Maxsunset/SilverGuard/SilverGuard/docs/老人摔倒检测系统-三序工坊队-2026.11.pptx

基于视觉，32单片机和物联网的老人摔倒检测系统

硬件/视觉：卢冠桦　STM32:陈哲 物联网：黄海巍
队伍：三序工坊队　　答辩日期：2026 年 11月

Notes: 开场：各位评委老师好，我们的项目是基于视觉和物联网的老人摔倒检测系统。用一台普通笔记本加一个普通摄像头，实时判断画面里的老人有没有摔倒，摔倒后不到半秒就报警，并通过 USB 转串口把信号送给单片机。整套系统不用显卡、不用穿戴设备，全部代码约 1000 行，中文注释完整。

## Slide 2

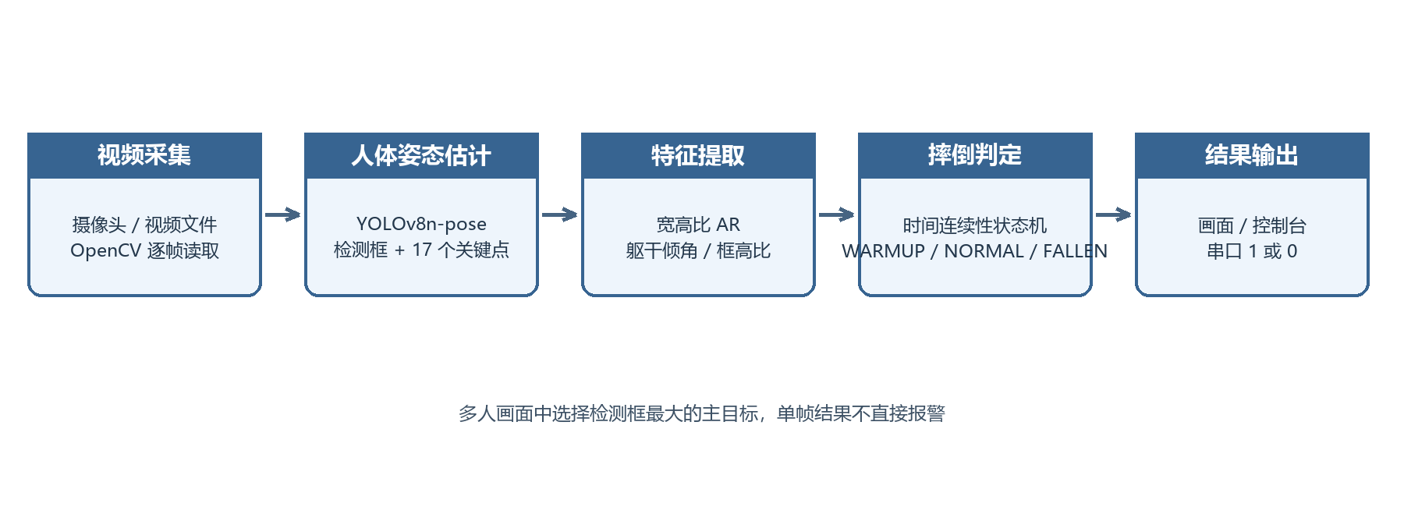
[picture p18: figure]

## Slide 3

三种姿态，用宽高比把蹲下和平躺分开

姿态 | 躯干倾角 | 宽高比 | 框高比
站立 | 0 ~ 9° | 0.30 ~ 0.80 | 0.93 ~ 1.04
蹲下 | 10 ~ 50° | 0.70 ~ 1.40 | 0.35 ~ 0.50
平躺 | 80 ~ 90° | 2.90 ~ 3.30 | 0.30 ~ 0.33

关键发现：蹲下和平躺的框高几乎一样（都缩到站立身高的 0.3~0.5），“框变矮”分不开两者
真正分得开的是宽高比：蹲下最多 1.4，平躺至少 2.9，中间有很宽的空白地带
把“框确实变宽”设为硬门槛后：蹲下一定不报，平躺一定报

倒地判定
宽高比 ≥ 1.8
且（躯干倾角 ≥ 60° 或 框高比 ≤ 0.55）

Notes: 这一段是演示场景的核心。实测数值来自真实视频逐帧测量，见 outputs/产品报告 第 3.5 节。

## Slide 4

# 宽高比门槛：蹲下不超过 1.4，平躺通常大于 2.9，因此取中间值 1.8

AR_THRESHOLD = 1.8
# 躯干与竖直方向的夹角：0° 为站直，90° 为完全躺平

ANGLE_THRESHOLD = 60.0
# 当前框高低于站立身高的 55%，作为倒地的辅助证据

COLLAPSE_RATIO = 0.55
def extract_features(kps, conf, box):
"""从检测框和关键点计算摔倒判定特征。"""
x1, y1, x2, y2 = [float(v) for v in box]
box_w = max(x2 - x1, 1e-6)
box_h = max(y2 - y1, 1e-6)

# 左右肩、左右髋分别取中点；单侧不可见时用另一侧代替

shoulder = _mid(_point(kps, conf, L_SHOULDER),
_point(kps, conf, R_SHOULDER))
hip = _mid(_point(kps, conf, L_HIP),
_point(kps, conf, R_HIP))
angle = None
if shoulder is not None and hip is not None:
dx = hip[0] - shoulder[0] # 肩髋之间的水平偏移
dy = hip[1] - shoulder[1] # 肩髋之间的垂直偏移
# 相对竖直方向的夹角，画面 y 轴向下不影响绝对值计算

angle = math.degrees(math.atan2(abs(dx), abs(dy) + 1e-6))
return {"aspect": box_w / box_h,
"angle": angle,
"box_height": box_h}

## Slide 5

一个字符（摔倒 1 / 正常 0）

信号 | 发送时机 | 单片机动作
字符 1 | 确认摔倒（每 100 毫秒重发） | 蜂鸣器 + 红灯 + 继电器
字符 0 | 正常 / 已恢复（每 100 毫秒重发） | 全部输出复位

默认只发一个字符：单片机一个 if 就能用
正常时每 100 毫秒发一次 0、摔倒后一直发 1、人起身又变回 0（★ 摔倒期间重发的仍是 1)

Notes: 单片机那一半的工作量可以压到不到 20 行。完整接线、协议表、故障排查见 outputs/单片机对接指南.md。PC 侧默认 115200、8N1，发的是单个字符不带换行。现场如果单片机没反应，先跑 mcu_link.py --diag 看实际生效的波特率和写出的字节数：有字节数就说明 PC 没问题，再查波特率是否一致、TX/RX 是否接反、GND 是否共地、单片机代码是不是在等换行。

## Slide 6

def __init__(self, link, detector, interval=0.1):
self.link = link
self.detector = detector
self.interval = interval
self._stop_event = threading.Event()
self._thread = threading.Thread(target=self._run, daemon=True)
def _run(self):
next_at = time.monotonic()
while not self._stop_event.is_set():
# 只发送单字节 ASCII：摔倒 = '1'，正常/恢复 = '0'

data = b"1" if self.detector.state == "FALLEN" else b"0"
self.link.write(data) # write 内部会 FlushFileBuffers
next_at += self.interval
delay = next_at - time.monotonic()
if delay < 0: # 发送偶发超时后重新对齐节拍
next_at = time.monotonic() + self.interval
delay = self.interval
self._stop_event.wait(delay)
def start(self):
self._thread.start()
def stop(self):
self._stop_event.set()
self._thread.join(timeout=1.0)

## 硬件优点

采用12V电池独立供电，利用DCDC+LDO输出5V和3.3V，可在停电下运行

01

模块化设计，便于更换

02

## 单片机

## Slide 9

02 / 开源

全部源码与文档开源：可复现、可追溯

github.com/Maxsunset/SilverGuard

完整源码 · 接线文档 · 关键修复的提交记录

源码

固件全部源码（Core/Src · SSD1306 驱动 · CMSIS）

文档

docs/wiring.md：引脚与接线，含 ESP8266 八脚说明

可追溯

关键修复都有提交记录，能查到“为什么这么改”

⭐ 我们不只给出“能跑的代码”，也给出“为什么这样写”的依据。

02

## Slide 10

05 / 架构

四层架构：感知 → 决策 → 执行 → 远程

感知层

摄像头 + 视觉判断（上位机）→ 串口每 100 ms 1 字节（0=正常 / 1=摔倒） · 按键（PA0）

决策层

六态状态机 · 定时器节拍 · 看门狗

执行层

OLED 汉字屏 · 蜂鸣器警笛 · 报警灯 · 语音播报

远程层

ESP8266（USART1）→ MQTT → 手机 / 小程序

⭐ 关键取舍：判断在本地完成、结果立刻联网；画面与视频上云作为可选扩展

05

## Slide 11

07 / 核心设计 ②

本地三层滤波：让报警只在真的需要时响

5 帧连续窗口
抗抖动

串口每 100 ms 一帧，连续 5 帧完全一致才更新结论

①

→ 单帧抖动、误码被直接丢弃

②

5 s 检查窗
可撤销

进入检查后仍采信上位机：报 0 立即退回待机，满 5 s 才升级

→ 短时误报在 5 s 内自动撤销

③

10 s 本地确认
拒收信息

进入预备报警后不再采信串口结论，只能长按取消或等 10 s 到期

→ 确认期内不会被后续数据“翻盘”

⭐ 三层是串联的：任何一层没通过，都不会进入正式报警

07

## Slide 12

06 / 核心设计 ①

全自动监控：摄像头在家里看懂，只把结论发出去

摄像头采集

现场摄像头持续拍摄

本地视觉判断

PC 端运行 Python 视觉

只发结果

串口每 100 ms 1 字节：0 正常 / 1 摔倒

多级确认

STM32 状态机逐级升级报警

▍识别在本地 视觉判断在本地完成，串口只传 0/1，通信量极小
▍心跳即在线 每 100 ms 一帧；200 ms 收不到就判掉线，屏幕与手机同时反映
▍两条腿走路 联网是核心价值；本地声光与语音不依赖网络

⭐ 一句话：监控是自动的，判断在本地，结论第一时间联网到家人手机。

06

## Slide 13

08 / 核心设计 ③

心跳检测：100 ms 一帧，200 ms 判掉线

为什么 100 ms 一帧

视觉 10 fps 足够判断跌倒；字节级上报，流量极小（每帧仅 1 字节）

上位机每 100 ms 发 1 字节

为什么 200 ms 判掉线

≈ 容忍 1 次丢帧，又不至于“断了很久还显示在线”；心跳周期 : 掉线阈值 = 1 : 2

掉线后怎么恢复

屏幕显示离线；上位机继续发心跳，收到即回到待机/检查（无需重启）

连续 2 帧未到 = 200 ms → 判掉线

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
⭐ 一串 0/1 里没有“我还活着”的信息，所以心跳必须单独设计——这就是这层的全部理由。

08

## Slide 14

09 / 核心设计 ④

六态状态机：不止单向推进，按键可随时跳变

① 主路径：数据与定时驱动

offline

断线/无信号

3 s

0

standby

在线待机

1（直通）

1

0（退回）

checking

确认中 5 s

5 s

standby

② 跳变：按键长按 / 心跳掉线

3 s

3 s

掉线

长按

offline

长按

alarm

长按

alarm_cancel

取消确认 3 s

alarm

报警中

10 s

pre_alarm

预备报警 10 s

checking

掉线

数据 / 定时

长按（按钮）

掉线（200 ms 无心跳）：仅 standby / checking 会回 offline

09

## Slide 15

10 / 核心设计 ⑤

看得见、听得到：没有手机也要能自救

手段 | 实现方式 | 设计要点
屏幕提示 | 128×64 OLED（I²C1），自绘 16×16 汉字点阵 | 汉字直读，不用记图标含义
警笛声 | TIM3 PWM 驱动蜂鸣器：1.80–3.00 kHz 扫频、占空比 ≈50% | 扫频更“抓耳”，不会和家电提示音混淆
报警灯 | PB0 独立灯，报警时点击闪烁（12 V 高电平点亮） | 听不见也能看见
语音播报 | SYN6288（USART3，9600）：报警/取消语音提示 | 安抚 + 指导，降低恐慌

⭐ 一个细节：蜂鸣器模块是“低电平触发”，因此“关闭”必须输出恒高，否则待机会一直通电发热。
我们最终把“关闭态”定义为 CCR > ARR（PWM 恒高），待机电流才回到 ≈0。

10

## Slide 16

12 / 核心设计 ⑦

掉电、死机、抖动：让“报警”不会因为意外而丢

看门狗（IWDG）

主循环每轮喂狗，约 6.5 s 未喂即复位；任何一路卡死都能自恢复

报警状态存 BKP

报警中意外复位，重新上电后仍回到“报警中”，不会悄悄安静下来

只发“变化”

状态未变不重复上报；网络恢复后补发当前状态，避免手机端停在旧状态

去重与短路保护

状态去重 + 发送失败退避，避免刷屏与“假在线”

12

## Slide 17

物联网

## Slide 18

整体链路 ｜ 一条摔倒消息的完整旅程

先看全景图，后面每一页拆开讲其中一段

⭐ 单片机只负责"发现"，小程序负责"把摔倒变成一次可靠的、能送到人手上的报警"。

02

02 / 10

📟

单片机

加速度传感器
检测到摔倒

EMQX 服务器

公共 MQTT Broker
消息中转站

📡

连上 Broker 收消息
解析 · 去重 · 存库

📱

微信云开发

云函数 + 云数据库
兜底落库 · 发通知

☁️

👵

家人手机

订阅消息弹窗
几秒内知道

➜

➜

小程序

➜

➜

① 连接：小程序 ↔ 单片机怎么见面

小程序不能直连单片机的 WiFi 热点，双方通过 MQTT 协议在一个公共服务器（Broker）上"见面"——单片机往主题里发消息，小程序订阅同一个主题就能收到。对应第 3–5 页。

② 运作：收到消息后小程序做什么

解析消息格式 → 15 秒去重 → 写入本地与云端 → 弹窗告警 → 云函数发订阅消息给家人。断网还能自动重连、补齐漏掉的记录。对应第 6–8 页。

③ 界面：三个页面怎么呈现这些数据（第 9 页）

④ 总结：一条消息从头到尾 8 步走完（第 10 页）

## Slide 19

连接 ① ｜ 小程序怎么"看见"单片机的消息

双方都连同一个公共 MQTT 服务器，靠"主题"对上话

utils/mqtt-client.js —— 建立连接（真实代码）

wx.connectSocket({
url: 'wss://broker.emqx.io:8084/mqtt', // wss = 加密 WebSocket；8084 是 MQTT over WS 的端口
protocols: ['mqtt'], // ★ 必须声明子协议 mqtt，少这一行握手直接失败
})
this._socket.onOpen(() => this._sendConnect()) // Socket 打开后，立刻发 CONNECT 登录报文（下一页）

⭐ 单片机和手机不直接认识对方——它们只是在同一个"留言板"上，一个写、一个读。

03

03 / 10

MQTT 是什么？——一条"留言板"

单片机把消息发到主题 silverguard/fall 上， 小程序订阅同一个主题——谁发的、谁收的，中间服务器全管。

小程序的特殊限制

微信不允许小程序开普通 TCP 连接（MQTT 默认的 1883 端口用不了）， 只能走 wx.connectSocket 的 WebSocket——所以握手方式要变通。

硬性要求 ①：protocols: ['mqtt'] 不传，服务器返回的不是 101 状态码，连接必挂——这是实测踩过的坑。

硬性要求 ②：地址必须以 wss:// 开头——微信强制加密连接，ws:// 明文会被拒。

## Slide 20

连接 ② ｜ CONNECT 登录报文：亲手拼二进制

小程序没有现成 MQTT 库可用——CONNECT 报文是一个字节一个字节拼出来的

⭐ 握手成功只差一个字节——标志位必须与报文里实际带的字段完全一致。

04

04 / 10

utils/mqtt-client.js —— CONNECT 报文核心（节选）

// 可变头：协议名 "MQTT" · 协议等级 Level 4 · keepAlive 60 秒
const flags = 0x02 // 只有 cleanSession 一个标志位
// 0x02 = 0000 0010：第 1 位表示"清会话"
// ★ 不能顺手写 0xC2（1100 0010）——那是"带用户名+密码"
// 的标志，但报文里并没有这两个字段，标志位与实际
// 内容不一致，Broker 会按协议错误直接断开连接
buf.push('MQTT'.length, ...bytes('MQTT'), 4, flags, 0, 60)

为什么手写？

npm 上的 MQTT 库依赖 TCP 和 Node API，小程序环境跑不起来——只能按协议文档自己拼字节。

flags：身份的"暗号"

8 个比特每个都有含义。填了"有密码"却没给密码，等于对暗号对不上，当场被踢。

clientId：手机用 silverguard-app-xxx，设备用 silverguard-dev-1——同一主题下互不干扰。

keepAlive 60s：每 60 秒互发一次心跳，服务器据此判断单片机还在线没在线。

## Slide 21

运作 ① ｜ 单片机"说的话"：一条消息长什么样

摔倒时单片机只发一串文字，小程序负责把它翻译成报警

utils/fall-handler.js —— 消息解析（核心节选）

function handle(payload) { // 所有设备消息的唯一入口
if (payload === 'online' || payload === 'offline') {
emitter.emit(EVENT_DEVICE, payload) // 在线报文：只刷新图标，不写记录、不告警
return
}
if (!/^1\/0\/fall/.test(payload)) return // 正则判断：不是摔倒报文就忽略
if (isDuplicate(true, Date.now())) return // 15 秒去重（下一页细讲）
saveAndAlert({ device: '1', fell: true, ts: Date.now() }) // 入库 + 弹窗告警
}

05

05 / 10

设备编号

1

/

0 = 检测到摔倒

0

/

fall

事件类型

/

normal

来源备注

设计要点：两种报文走两条分支——摔倒事件要"留痕 + 喊人"，在线状态只改一个图标。职责分清，互不掺和。

为什么用正则：/^1\/0\/fall/.test() 一行就能确认"这是设备 1 发的摔倒"，比字符串切割更稳。

⭐ 单片机只发一串字符，"翻译成报警"的全部智能都在小程序这一端。

## Slide 22

运作 ② ｜ 确认是摔倒后：去重 → 入库 → 喊人

一次摔倒只响一次铃——15 秒去重窗是秩序的关键

utils/fall-handler.js —— 15 秒去重窗（真实代码）

const DEDUPE_WINDOW = 15000 // 15 秒（毫秒）

function isDuplicate(fell, ts) {
const last = records.find(r => r.fell === fell)
// 找最近一条同类记录
return last && ts - last.ts < DEDUPE_WINDOW
// 距上次摔倒不到 15 秒 → 是同一次
}

信号可能经两条路径各到一次，不去重就会记两条——入口处统一去重，所有链路自动受益。

⭐ 四步流水线只做 200 毫秒——老人摔倒到小程序报警，比拨一个电话快得多。

06

06 / 10

解析 · 认出摔倒报文

1

去重 · 15 秒内只认一次

2

入库 · 本机 + 云数据库

3

告警 · 弹窗震动 + 通知家人

4

告警做什么：页面状态变红、本机弹窗 + 震动（实测 TOAST_OK），并把事件交给云函数去发微信订阅消息。

JS 语法点：find() 在数组里找第一条满足条件的记录——比 for 循环更短、更不易写错。

## Slide 23

运作 ③ ｜ 断网、切后台：消息凭什么不丢

两道保险：断了自动重连，漏了按时间补齐

07

07 / 10

保险 ① · 自动重连（mqtt-client.js）

onClose() {
setTimeout(() => this.connect(), 10000)
// 连接断了：10 秒后自动重连
}
onShow() {
if (!this._link) this.connect()
// 用户切回小程序时，再查一次
}

小程序切后台、锁屏都会被微信挂起断线——重连是常态，必须自动化。

保险 ② · 增量补齐（cloudbus.js）

const { data } = await db.collection('fall_events')
.where({ ts: _.gt(lastTs) })
// 只拉"上次看到的时间点之后"的
.orderBy('ts', 'asc').get()
data.forEach(e => saveAndAlert(e, { quiet: true }))
// 补齐的旧事件只入库，不弹窗吓人

断线期间发生的摔倒会先落到云数据库——重新连上后按时间戳把漏掉的补回来。

lastTs 是什么：本机记着"最后看到哪条"，断线重连后从它往后拉——不多不少，正好补上缺口。

quiet: true 的体贴：补齐只更新列表，不连弹一串旧告警——可靠但不吓人。

⭐ 网络会断、小程序会被挂起——但"重连 + 补齐"让记录一条都不少。

## Slide 24

运作 ④ ｜ 云端半场：云函数落库 + 实时推送手机

云函数负责"存下来、喊出去"，watch 负责"页面立刻变"

⭐ 云端 = 可靠的记事本 + 喊话员；watch = 页面和云端之间的一条"专线"。

08

08 / 10

云函数 mqttWebhook（节选）

exports.main = async (event) => {
await ensureCollection('fall_events')
// 集合不存在就自动建，零手工配置
await addDoc('fall_events', {
...payload, ts: uniqueTs(),
}) // uniqueTs：同毫秒事件 +1ms，
// 增量拉取时一条不漏
await sendFallAlert(payload) // 逐人发通知
}

云函数跑在腾讯服务端——小程序没开它也在工作。

小程序端 watch 实时订阅（cloudbus.js）

this._watcher = db.collection('fall_events')
.where({ ts: _.gt(lastTs) })
.watch({
onChange: (snapshot) => {
refresh(snapshot.docs)
// 云端一有新记录，页面立刻更新
},
})

watch 是云数据库的"长连接"——不用轮询刷新，数据到了推给你。

家人怎么收到：云函数调用微信订阅消息接口，锁屏也能弹出通知——通知只能服务端发，小程序自己发不了。

JS 语法点：...payload 展开运算符把旧对象的字段摊开进新对象，改哪项补哪项。

## Slide 25

界面 ｜ 三个页面，各自管一件事

老人看得清、家人查得到、你自己测得了

⭐ 三个页面各司其职：首页管"现在"，记录管"过去"，我的管"以后怎么用"。

09

09 / 10

· 一块大卡片显示设备在线状态：绿色在线 / 红色摔倒 / 灰色离线——不给"假在线"信号
· 摔倒时整页变红 + 弹窗 + 震动
· 数据由全局消息总线推送，页面只负责"显示结果"

· 历史摔倒记录按时间倒序排列
· 支持按"摔倒 / 自测"筛选
· 数据来自云数据库，断线补齐的记录也会出现在这里——事后可查、可回溯

· 填 MQTT 地址、订阅通知
· 离线自测按钮：没有硬件也能注入一条模拟摔倒，现场演示全流程
· 管理联系人：摔倒后通知发给谁

🏠

首页 · 现在安全吗

📋

记录 · 发生了什么

⚙️

我的 · 怎么用起来

设计原则：给老人看的字要大、状态色只用三种——信息少而准，比"功能多"重要。

离线自测的价值：答辩现场没设备也能演示——一条命令注入消息，全链路当场跑通。

## Slide 26

总结 ｜ 一条摔倒消息的 8 步旅程

把前面所有页串成一条线——答辩陈述可以照这条线讲

三句话记住本项目：连接靠 MQTT over WebSocket；可靠靠去重 + 重连 + 补齐；家人收得到靠云函数发通知。

⭐ 老人摔倒 → 全家几秒内知道——小程序把一串字符，变成了一次送到人手上的救援。

10

10 / 10

① 检测

单片机加速度传感器判定摔倒

② 发消息

MQTT 发布 1/0/fall 到 Broker

③ 收到

小程序经 WebSocket 订阅收到消息

④ 解析去重

认出摔倒报文，15 秒窗去重

➜

➜

➜

⑤ 入库

写本机缓存 + 云数据库 fall_events

⑥ 页面刷新

watch 推送，首页立即变红弹窗

⑦ 发通知

云函数逐人发微信订阅消息

⑧ 家人知道

锁屏弹通知，几秒内接到报警

➜

➜

➜

谢谢各位老师，欢迎提问 🙏

## Slide 27

一句话总结

装在家里的一双眼睛：
自动发现 → 多级确认 → 本地报警 → 联网告知家人。
每一步，都有实测数据支撑。

下一步：多传感器融合 · 位置上报 · 多设备隔离 · 正式发布

感谢评委老师，欢迎提问。
