Maxsunset/SilverGuard/SilverGuard/docs/SilverGuard_答辩_设计思路与亮点.pptx

科技创新节 · 项目答辩

SilverGuard
老人摔倒守护装置

从“摔倒”到“有人知道”：一套会自己看、还会自己报的守护装置
摄像头自动识别 + STM32 多级确认 + 本地声光语音 + ESP8266 联网直达手机

答辩人：___________ 指导教师：___________ 日期：______

## Slide 2

02 / 开源

全部源码与文档开源：可复现、可追溯

github.com/Maxsunset/SilverGuard

完整源码 · 接线文档 · 关键修复的提交记录

源码

固件全部源码（Core/Src · SSD1306 驱动 · CMSIS）

文档

docs/wiring.md：引脚与接线，含 ESP8266 八脚说明

可追溯

关键修复都有提交记录，能查到“为什么这么改”

⭐ 我们不只给出“能跑的代码”，也给出“为什么这样写”的依据。

02

## Slide 3

03 / 问题

独居老人跌倒：发现晚一步，代价可能就是生命

▍现实痛点 跌倒后 1 小时内获救率最高，但独居场景常常“无人知晓”
▍时间窗口 从“摔倒”到“有人来”的每一分钟，都在降低生存概率

云摄像头方案

只能看，不会报警
需要人一直盯

智能手环

要充电、要佩戴
跌倒时可能没戴

纯按钮呼救

摔了够不到
意识不清按不了

→ 我们的判断：让摄像头不只“看得见”，还能自动判断，并把报警送到家人手机上

03

## Slide 4

04 / 目标

设计目标与硬约束：先定边界，再谈功能

维度 | 我们要做到的 | 为什么这样定
成本 | 整机主要器件 ≤ 百元级（STM32F103 + ESP8266） | 让普通家庭买得起、能量产
隐私 | 摄像头在室内，采集范围需告知与授权 | 老人接受度是能否落地的关键
可用性 | 断网时本地声/光/语音告警照常工作 | 网络不可靠是常态，不能赌网络
时效 | 从检测到本地报警 ≤ 数秒；远程通知目标 ≤ 1 s | 越早提醒，越可能被及时处理
误报 | 分级确认：先提示、再倒计时、最后报警 | 误报一次，老人就会关掉它
可维护 | 每路外设独立状态机，互不阻塞 | 一个外设卡死不能拖垮整机

04

## Slide 5

05 / 架构

四层架构：感知 → 决策 → 执行 → 远程

感知层

摄像头 + 视觉判断（上位机）→ 串口每 100 ms 1 字节（0=正常 / 1=摔倒） · 按键（PA0）

决策层

六态状态机 · 定时器节拍 · 看门狗

执行层

OLED 汉字屏 · 蜂鸣器警笛 · 报警灯 · 语音播报

远程层

ESP8266（USART1）→ MQTT → 手机 / 小程序

⭐ 关键取舍：判断在本地完成、结果立刻联网；画面与视频上云作为可选扩展

05

## Slide 6

06 / 核心设计 ①

全自动监控：摄像头在家里看懂，只把结论发出去

摄像头采集

现场摄像头持续拍摄

本地视觉判断

PC 端运行 Python 视觉

只发结果

串口每 100 ms 1 字节：0 正常 / 1 摔倒

多级确认

STM32 状态机逐级升级报警

▍识别在本地 视觉判断在本地完成，串口只传 0/1，通信量极小
▍心跳即在线 每 100 ms 一帧；200 ms 收不到就判掉线，屏幕与手机同时反映
▍两条腿走路 联网是核心价值；本地声光与语音不依赖网络

⭐ 一句话：监控是自动的，判断在本地，结论第一时间联网到家人手机。

06

## Slide 7

07 / 核心设计 ②

本地三层滤波：让报警只在真的需要时响

5 帧连续窗口
抗抖动

串口每 100 ms 一帧，连续 5 帧完全一致才更新结论

①

→ 单帧抖动、误码被直接丢弃

②

5 s 检查窗
可撤销

进入检查后仍采信上位机：报 0 立即退回待机，满 5 s 才升级

→ 短时误报在 5 s 内自动撤销

③

10 s 本地确认
拒收信息

进入预备报警后不再采信串口结论，只能长按取消或等 10 s 到期

→ 确认期内不会被后续数据“翻盘”

⭐ 三层是串联的：任何一层没通过，都不会进入正式报警

07

## Slide 8

08 / 核心设计 ③

心跳检测：100 ms 一帧，200 ms 判掉线

为什么 100 ms 一帧

视觉 10 fps 足够判断跌倒；字节级上报，流量极小（每帧仅 1 字节）

上位机每 100 ms 发 1 字节

为什么 200 ms 判掉线

≈ 容忍 1 次丢帧，又不至于“断了很久还显示在线”；心跳周期 : 掉线阈值 = 1 : 2

掉线后怎么恢复

屏幕显示离线；上位机继续发心跳，收到即回到待机/检查（无需重启）

连续 2 帧未到 = 200 ms → 判掉线

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
⭐ 一串 0/1 里没有“我还活着”的信息，所以心跳必须单独设计——这就是这层的全部理由。

08

## Slide 9

09 / 核心设计 ④

六态状态机：不止单向推进，按键可随时跳变

① 主路径：数据与定时驱动

offline

断线/无信号

3 s

0

standby

在线待机

1（直通）

1

0（退回）

checking

确认中 5 s

5 s

standby

② 跳变：按键长按 / 心跳掉线

3 s

3 s

掉线

长按

offline

长按

alarm

长按

alarm_cancel

取消确认 3 s

alarm

报警中

10 s

pre_alarm

预备报警 10 s

checking

掉线

数据 / 定时

长按（按钮）

掉线（200 ms 无心跳）：仅 standby / checking 会回 offline

09

## Slide 10

10 / 核心设计 ⑤

看得见、听得到：没有手机也要能自救

手段 | 实现方式 | 设计要点
屏幕提示 | 128×64 OLED（I²C1），自绘 16×16 汉字点阵 | 汉字直读，不用记图标含义
警笛声 | TIM3 PWM 驱动蜂鸣器：1.80–3.00 kHz 扫频、占空比 ≈50% | 扫频更“抓耳”，不会和家电提示音混淆
报警灯 | PB0 独立灯，报警时点击闪烁（12 V 高电平点亮） | 听不见也能看见
语音播报 | SYN6288（USART3，9600）：报警/取消语音提示 | 安抚 + 指导，降低恐慌

⭐ 一个细节：蜂鸣器模块是“低电平触发”，因此“关闭”必须输出恒高，否则待机会一直通电发热。
我们最终把“关闭态”定义为 CCR > ARR（PWM 恒高），待机电流才回到 ≈0。

10

## Slide 11

11 / 核心设计 ⑥

裸机上的 MQTT：不引入 RTOS，也不让网络拖垮本地

▍非阻塞状态机 AT 指令逐步推进（CWMODE→CWJAP→CIPMUX→CIPSTART→CIPSEND），超时与重试全部显式
▍中断只入队 串口中断只把字节塞进 512 B 环形缓冲，解析全在主循环，避免中断里阻塞丢字节
▍自愈 串口错误回调清标志并重新武装接收，一次溢出不会让接收链永久停摆

断线重试退避（秒）
2 → 4 → 8 → 16 → 32 → 60；连续 3 次仍失败则回到第 1 步重新握手

为什么不用 RTOS？
任务数少、时序简单，裸机状态机已够；中断少、栈小，更好推理。

60s

8s

16s

32s

2s

4s

11

## Slide 12

12 / 核心设计 ⑦

掉电、死机、抖动：让“报警”不会因为意外而丢

看门狗（IWDG）

主循环每轮喂狗，约 6.5 s 未喂即复位；任何一路卡死都能自恢复

报警状态存 BKP

报警中意外复位，重新上电后仍回到“报警中”，不会悄悄安静下来

只发“变化”

状态未变不重复上报；网络恢复后补发当前状态，避免手机端停在旧状态

去重与短路保护

状态去重 + 发送失败退避，避免刷屏与“假在线”

12

## Slide 13

13 / 亮点

把“看不见的 bug”变成可复现的证据

案例 1

现象

OLED 全黑，重烧无效

可能

驱动？初始化？时序？供电？

定位

全地址扫描（0 个设备）+ 内上拉探测 → 两根线被接反

行动

交换 SCL/SDA，屏幕立即点亮；显示代码一行未改

案例 2

现象

WiFi 明明开着，模块却说“找不到该网络”

可能

信号弱？密码错？热点 5 GHz？

定位

抓模块原始扫描行：名字里的撇号是 ’（U+2019），我写的是 '

行动

把手机名与代码里的 SSID 逐字节对齐，一次连通

案例 3

现象

蜂鸣器不响，还发烫

可能

频率不对？占空比太高？

定位

量静态：待机就在通电 → 模块是低电平触发，代码待机输出低电平

行动

把“关闭”定义为 PWM 恒高，待机电流回到 ≈0

⭐ 我们最看重的不是“一次成功”，而是“出错时能定位”：把现象 → 可能 → 证据 → 行动 变成固定动作

13

## Slide 14

14 / 实测

不是“理论上”，而是实测出来的数字

72 MHz

MCU 主频（HSE 8M ×9）

≈23 KB

Flash 占用（Code+RO）

≈3.2 KB

RAM 占用（RW+ZI）

200 ms

串口心跳判据（2 帧未到）

项目 | 实测/实现值 | 说明
警笛扫频 | 1.80 – 3.00 kHz | TIM3：1 MHz 计数 / ARR 555→332
警笛占空比 | ≈ 50% | CCR = ARR/2，响度与发热的折中
串口帧率 | 10 帧/秒（100 ms/帧） | 上位机每帧 1 字节：0x00 正常 / 0x01 摔倒
状态固化窗口 | 连续 5 帧（≈500 ms） | 5 字节全同才更新，滤掉单帧抖动
确认 / 预备 / 取消 | 5 s / 10 s / 3 s | 分级确认，给本人反应时间
看门狗复位窗 | ≈ 6.5 s | IWDG 64 分频、重装 4095
串口接收缓冲 | 512 B 环形 | 中断入队、主循环排空，丢字节问题消除
上报状态 | 1（报警）/ 0（取消） | 线上只传最必要的字节

14

## Slide 15

15 / 边界

我们清楚它现在做不到什么

▍识别仍有边界 单摄像头视角：遮挡、逆光、夜间识别率会下降
▍画面未上云 画面/视频云端存档与回放尚未做，可作为扩展（更直观、便于回溯）
▍无位置信息 只报“状态”，不报“在哪”；后续可加定位与房间级判断
▍多设备未隔离 演示版是单设备；面向多人使用需要设备绑定与数据隔离
▍小程序未发布 现为体验版范围；正式对外需备案与服务类目
▍外观与结构 仍是开发板形态，下一步做外壳与摆放形态

→ 先把“可靠地把报警发出去”做扎实，再谈更多传感器与更好看的外形

15

## Slide 16

一句话总结

装在家里的一双眼睛：
自动发现 → 多级确认 → 本地报警 → 联网告知家人。
每一步，都有实测数据支撑。

下一步：多传感器融合 · 位置上报 · 多设备隔离 · 正式发布

感谢评委老师，欢迎提问。
