Maxsunset/SilverGuard/SilverGuard/IMG_2740.jpg

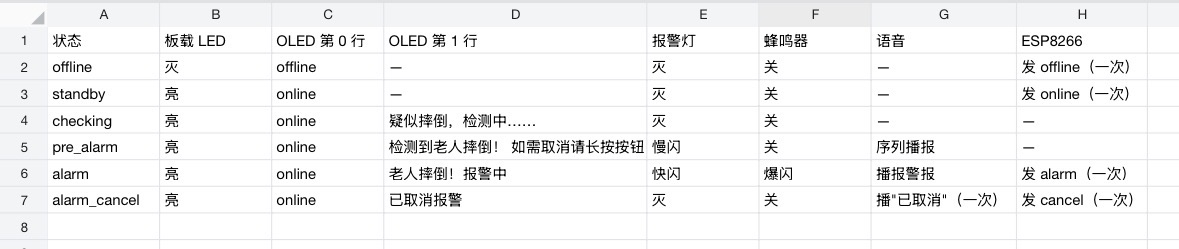
SilverGuard/IMG_2740.jpg
