Maxsunset/SilverGuard/SilverGuard/SilverGuard.ioc

Mcu.UserName=STM32F103C8Tx
PA0-WKUP.GPIO_Label=Button
PA0-WKUP.Signal=GPIO_Input
PA10.GPIO_Label=ESP8266_RX
PA10.Signal=USART1_RX
PA13.Signal=SYS_JTMS-SWDIO
PA14.Signal=SYS_JTCK-SWCLK
PA2.GPIO_Label=Host_computer_TX
PA2.Signal=USART2_TX
PA3.GPIO_Label=Host_computer_RX
PA3.Signal=USART2_RX
PA6.GPIO_Label=buzzer
PA6.Signal=S_TIM3_CH1
PA9.GPIO_Label=ESP8266_TX
PA9.Signal=USART1_TX
PB0.GPIO_Label=Light
PB0.Signal=GPIO_Output
PB10.GPIO_Label=SYN6288_TX
PB10.Signal=USART3_TX
PB11.GPIO_Label=SYN6288_RX
PB11.Signal=USART3_RX
PB6.GPIO_Label=OLED_SCL
PB6.Signal=I2C1_SCL
PB7.GPIO_Label=OLED_SDA
PB7.Signal=I2C1_SDA
PC13-TAMPER-RTC.GPIO_Label=On_board_light
PC13-TAMPER-RTC.Signal=GPIO_Output
PD0-OSC_IN.Signal=RCC_OSC_IN
PD1-OSC_OUT.Signal=RCC_OSC_OUT
