Maxsunset/SilverGuard/(commit log)

2026-10-11 首次提交：SilverGuard 完整工程（Core/SSD1306/Drivers/CMSIS）+ 生成器脚本与文档
2026-10-14 MQTT 联网打通 + 屏幕与交互修正
    - ESP8266 自实现 MQTT over AT：CWJAP/CIPMUX/CIPSTART + 手拼 MQTT 帧 + 30s PINGREQ 保活 + 2/4/8/16/32/60s 退避重试
    - 屏幕：顶行 offline/online 判据修正（屏幕离线或传感器掉线都显示 offline）、内容变了才刷新、上电顺序说明
    - 交互：取消画面 3 秒、取消后按传感器状态回 offline/standby、报警灯极性还原为原始（亮=高）
    - 文案：报警前提示补上「按」字（请长按按钮）
    - 驱动：SSD1306 接口移除半主机打印（消除 BKPT 卡死）、I2C 超时收紧到 10ms
    - 引脚随 CubeMX 重命名同步（Host_computer / SYN6288_YX / ESP8266 / OLED）
    - 文档：doc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
    [SilverGuard.ioc, driver_ssd1306_interface.c, main.c, main.h, oled_hz.h]
2026-10-14 修复 USART1 接收丢字节与传感器在线误判
    - HAL_UART_RxCpltCallback：sg.flag = 1 移入 USART2 分支，避免 ESP/语音串口数据被当成传感器有信号
    - USART1 改为 HAL_UART_Receive_IT + 512 字节环形缓冲，net_poll 从缓冲取字节（token 匹配逻辑与调用方不变）
    - net_flush 改为清空环形缓冲（仍在发命令之前调用，不会丢新回复）
    - 新增 HAL_UART_ErrorCallback：清 ORE/FE/NE/PE 并重新武装接收，防止一次溢出导致接收中断链停摆
    [main.c]
2026-10-14 清理仓库：不再跟踪 Keil 生成文件与本地备份
    - git rm --cached EventRecorderStub.scvd（Keil 自动生成，磁盘上保留）
    - git rm --cached SilverGuard.uvprojx.bak_before_microlib（本地备份，磁盘上保留）
    - .gitignore 增加 *.bak*（原来 *.bak 匹配不到 *.bak_before_*）与 *.scvd
2026-10-25 修复通知逻辑与蜂鸣器极性等 5 处问题
    - checking 分支补发 online：原来 offline→checking 不发消息
    - 预报警取消改为静默（新增 st.cancel_silent）
    - 取消出口按传感器状态直接落位；去重改为严格比较，移除重复入队
    - 蜂鸣器模块为低电平触发：关闭态改为 PWM 恒高，避免待机通电发热
    - MQTT 载荷由 alarm/cancel 改为 1/0
    [main.c]
2026-10-25 新增：科技节答辩 PPT
    - 12→13 页：新增第 2 页开源页，展示 GitHub 仓库地址
    - 内容基于实测数据（编译尺寸、扫频频段、200 ms 心跳、5 帧窗口等）
    - 含现象→可能→定位→行动的三个真实问题复盘
2026-10-25 答辩 PPT：按摄像头与联网为核心重构（共 14 页，新增第 6 页全自动监控）
2026-10-25 答辩 PPT：状态机改为完整转移图，删去不传云端式表述
    状态机页：6 状态环形布局 + 带条件标签的转移箭头 + 两条图例补全其余转移；问题页竞品改为“只能看不会报警”；目标页隐私行改为“室内摄像头需告知与授权”；架构/监控页删去“画面不出门”提法，改述为判断在本地、结果联网；局限页补“画面未上云可作为扩展”；kicker 恢复自动页码
2026-10-25 答辩 PPT：新增三层滤波与心跳检测两页，状态机改为双面板全连通转移图
    新增第 7 页本地三层滤波（5 帧窗口 / 5 s 检查窗 / 10 s 本地确认拒收）；新增第 8 页心跳检测（100 ms 一帧、200 ms 判掉线、1:2 比例、掉线恢复）；状态机页改为左主路径右跳变双面板，14 条转移全部画出并分色（数据/长按/掉线）；修正“仅 standby/checking 会因掉线回 offline”的旧错误
2026-10-31 新增：比赛作品成果报告（Word）
    按比赛报告样稿格式撰写：封面、一、设计思路（含摄像头监控/三层滤波/心跳检测/六态状态机/联网）、二、完整代码（真实源码全文）、三、各功能编译运行结果（含占位截图与实测资源占用）、四、优点与不足、五、改进方案、六、小结；附 5 张图（接线图与 4 张核心示意图）
2026-10-31 报告改为按模板大纲（七部分）
    一、课题内容和要求；二、需求分析；三、概要设计（含主要数据结构、摄像头监控、三层滤波、心跳检测、六态状态机、联网）；四、源程序代码；五、测试数据及其结果分析（含结果分析）；六、调试过程中的问题（五个真实问题的定位过程）；七、总结（优点、不足、改进方案、小结）。原六部分版本因文件被 Word 占用，另存为“_新版”
2026-10-31 报告统一为单一文件并按模板大纲定稿
    原“_新版”内容直接写回 SilverGuard_作品报告.docx，删除多余副本
2026-10-31 恢复按模板大纲的报告文件
    SilverGuard_作品报告.docx 被其他进程长期占用（既不能写入也不能删除），新版暂以 _新版.docx 交付；待占用释放后可覆盖并删除副本
2026-10-31 报告补充三、3 主要函数流程（含三张流程图）
    按模板补“主要函数流程”：main 主循环流程、main_state_machine 六态转移流程、ESP8266/net_poll 联网上报流程，各配一张流程图（图2~图4）；全文图号顺延为 1~14 递增；删除被占用期间产生的临时副本，报告恢复为单一文件
2026-10-31 流程图改为标准符号（椭圆起止/矩形处理/菱形判定/是否分支）
    图2 main 主程序：加“按键 triggered?”与“200ms 无新字节?”两个判定菱形，是分支走右侧处理框后汇回主干，主干回环；图3 状态机：掉线判定菱形 + switch 判定菱形 + 六个状态块 + 汇总，右侧独立面板给出 checking 的 if…else 嵌套判定；图4 联网：加“与上次报文相同?”与“发送成功?”两个判定菱形
2026-10-31 状态机流程图改为完整状态转移总图
    按用户口述补全：上电/复位 →（BKP 有未取消报警？）是→alarm / 否→offline；offline 三条出口（收 0→standby、收 1→checking、无字节自环维持）；standby（收 1→checking、200 ms 无信号→offline、长按→alarm）；checking（收 0→standby 撤销、满 5 s→pre_alarm、长按→alarm、掉线→offline）；pre_alarm（满 10 s→alarm、长按静默取消→alarm_cancel）；alarm（长按→alarm_cancel）；alarm_cancel（3 s 后 0→standby / 1→checking / 掉线→offline）；所有指向 offline 与 alarm 的连线分别汇入左侧与顶部轨道，再统一进入目标状态
2026-10-31 状态转移图整改：删除自环、直通线不再穿框、每次进入状态都带箭头头、消除文字重叠
    按用户反馈：删除 offline 自环；offline→checking 直通线改为从 checking 左侧进入（原先竖线穿过确认中框）；checking→standby 撤销线改为从 standby 右侧进入；左侧汇流轨与顶部汇流轨统一以箭头头进入 offline 与 alarm；alarm_cancel 的三条出口各自带箭头头；alarm 与 pre_alarm 通往 alarm_cancel 的竖线错开 x 不再重合；“先进入离线”注释移到左侧空白处，消除与长按轨文字重叠
2026-10-31 状态转移图再修：否分支接通、去除多余箭头头、去掉进入 alarm 的方框
    ① BKP 判定的“否”分支改为下探到主行再向右接入 offline 左边缘（原先停在框上方成断线）；② 折线统一封装为 route()：中间段只画直线、仅最后一段带箭头 ⇒ 每条转移只有唯一箭头头，消除拐角处的多余箭头头；③ 删除“(进入 alarm)”方框，改为纯文字标注；④ 直通线与撤销线分别从 checking 左侧、standby 右侧进入并各带一个箭头头
2026-10-31 状态转移图：删除两条进入 standby 的多余箭头，改为文字标注
    按用户要求删除 checking→standby（收到 0 撤销）与 alarm_cancel→standby（3 s 且收到 0）两条箭头；这两种转移改用文字标注保留在图上，避免信息丢失
2026-10-31 图注措辞修正：见表→见正文说明
2026-10-31 正文补充说明图3中改用文字标注的两条转移
    补充：checking 收到 0 撤销误报回 standby；alarm_cancel 满 3 s 后收到 0 回 standby。使图注“见正文说明”有依据
2026-10-31 图3：“是”标签从菱形斜边上移到右顶点外侧
2026-10-31 丰富报告：一二部分扩写、新增硬件与软件模块表、末尾加附录A核心代码
    一、课题内容和要求新增应用场景与技术路线；二、需求分析新增硬件需求与软件需求；三、概要设计新增 9 硬件模块设计（表3，含型号/接口/引脚/参数/选型理由）与 10 软件模块设计（表4，含主要函数与实现要点）；末尾新增附录 A 六态状态机主函数全套源码
2026-10-31 表号重排：硬件/软件模块表改为表1、表2，原表1、表2顺延为表3、表4
2026-10-31 硬件模块表列宽收窄至正文宽度内
2026-10-31 新增智识无界报告丰富版：软硬件模块细化、第一版第二版补复盘、末尾附状态机主函数
    原文件 智识无界报告.docx 未改动；新增 _丰富版：①主要设备及软件下补（一）硬件部分 8 项（主控/OLED/蜂鸣器/报警灯/SYN6288/ESP8266/交互与调试/PCB）与（二）软件部分 7 项（视觉程序/极简帧协议与 200 ms 掉线/小程序原生框架/自写 MQTT over WebSocket/EMQX 中转/云开发/调试工具）；②第一版、第二版各补一段复盘；③末尾新增“核心代码：六态状态机主函数”并贴 main_state_machine() 全文与说明
2026-10-31 智识无界报告：设计过程补主控（单片机）部分，详细功能补各类报警
    ① 设计过程新增“主控（单片机）部分”：三层滤波、心跳与掉线判定、六态状态机、本地告警驱动、联网上报、可靠性共 6 条；② 详细功能在原段之后补齐分级报警、声音报警、灯光报警、语音报警、屏幕报警、远程报警、可取消与防误报、掉线与复位提示共 8 条；原文件已备份为 .docx.bak
2026-10-31 智识无界报告插入三张流程图（原图），并按页宽缩放
    图1 主程序流程（main 主循环）放在“主控（单片机）部分”标题后；图2 六态状态转移总图放在“③ 六态状态机”段后（15.5 cm）；图3 联网上报流程放在“⑤ 联网上报”段后（11 cm）；图名按原文风格居中、10.5pt；插前已用 .bak 备份
2026-10-31 修复智识无界报告：● 列表被挤到右侧窄列的问题
    原因：这 5 条正文用的是 <w:numPr> 列表编号，其列表级别带有极大的左缩进，导致文字只占右侧三分之一并留下大片空白。处理：去掉 numPr（保留标题的编号样式不动），改为手工 ● 前缀 + 首行缩进 2 字符 + 1.5 倍行距 + 两端对齐，使之占满正文宽度；共修 5 段，标题 5 个编号保留
2026-10-31 作品报告：Keil 编译结果截图替换占位框
    把用户提供的 Keil 编译输出截图（Code=20122 RO-data=3814 RW-data=16 ZI-data=3256，0 Error(s) 0 Warning(s)，用时 3 s）插入“图 8 编译结果”，同时删除原虚线占位表；图名居中 10.5pt；插前已备份为 .bak
2026-10-31 PPT 队伍名改三序工坊队；报告表名移至表格上方
    ① PPT：第 1 页“队伍：三道工坊队”→“队伍：三序工坊队”，文件名同步改为“老人摔倒检测系统-三序工坊队-2026.11.pptx”；② 报告：把“表 1/表 2/表 4”的表名移到对应表格上方（中文规范：表名在上、图名在下），并设为与下段同页，避免表名被挤到下一页；编译资源占用表另加 keepNext/ cantSplit 以减少跨页
